Devoranima/nano_flight/docs/figures/fig4-i2c-bus.png

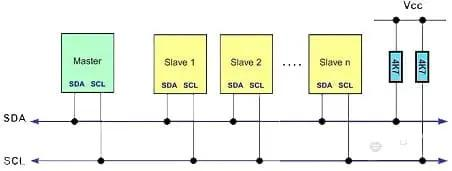
docs/figures/fig4-i2c-bus.png
