Devoranima/nano_flight/docs/figures/fig1-motor-layout.png

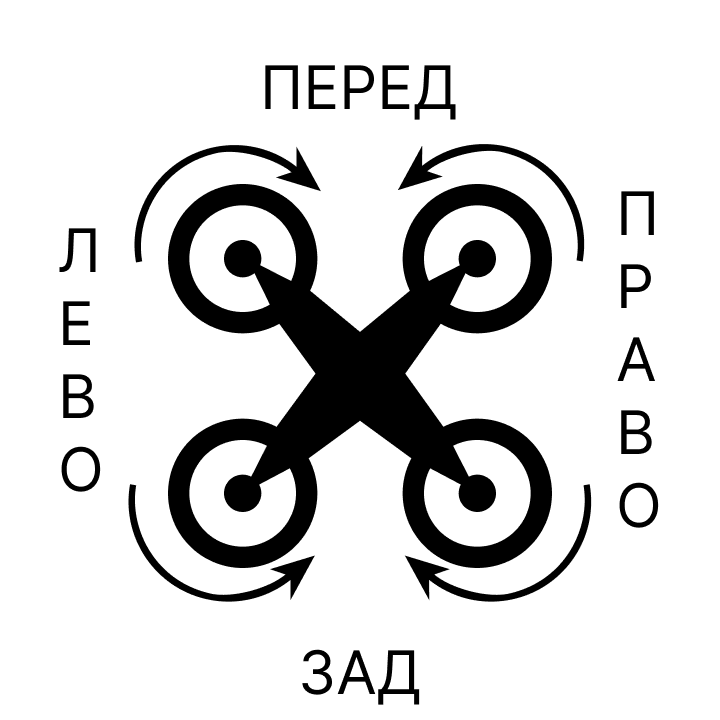
docs/figures/fig1-motor-layout.png
