Devoranima/nano_flight/(commit log)

2026-08-05 add sensor lib files
2026-08-06 add pid lib
